StrawsonDesign/EduMiP/Pictures/Wide Pic Back.JPG

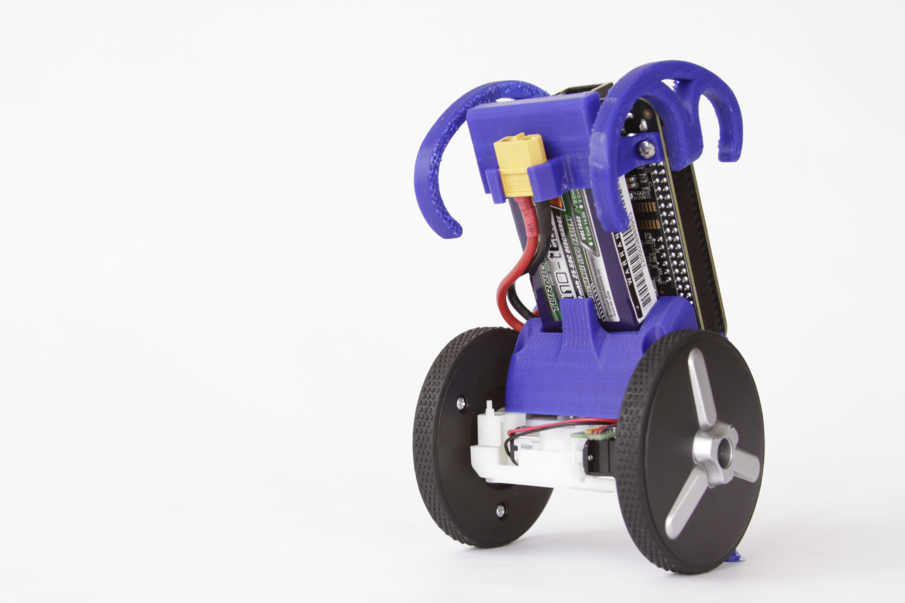
Pictures/Wide Pic Back.JPG
