StrawsonDesign/EduMiP/Renders/BeagleMiP Wide Back Render 1.JPG

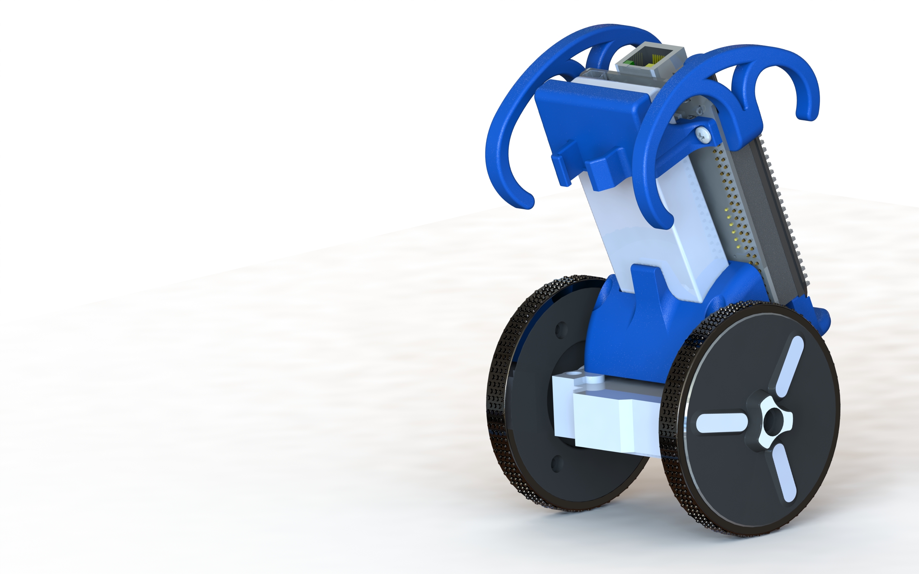
Renders/BeagleMiP Wide Back Render 1.JPG
