StrawsonDesign/EduMiP/README.md

# EduMiP
James Strawson 2015

EduMiP is a self-balancing robot built around the
BeagleBone Black and Robotics Cape.

Developed with the Coordinated Robotics Laboratory
at UCSD.
