StrawsonDesign/EduMiP/Pictures/EduMiP army 2.JPG

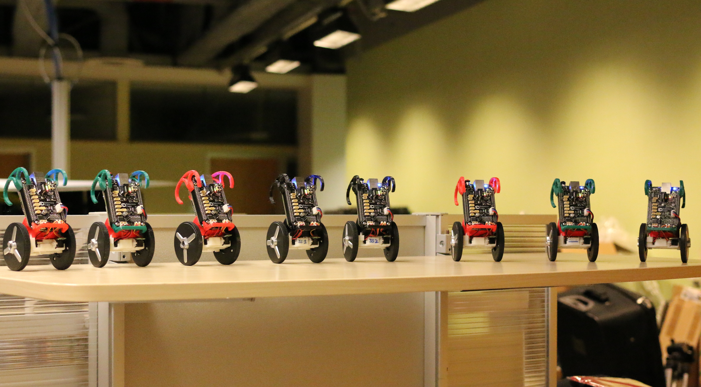
Pictures/EduMiP army 2.JPG
