StrawsonDesign/EduMiP/Pictures/Wide Pic Front.JPG

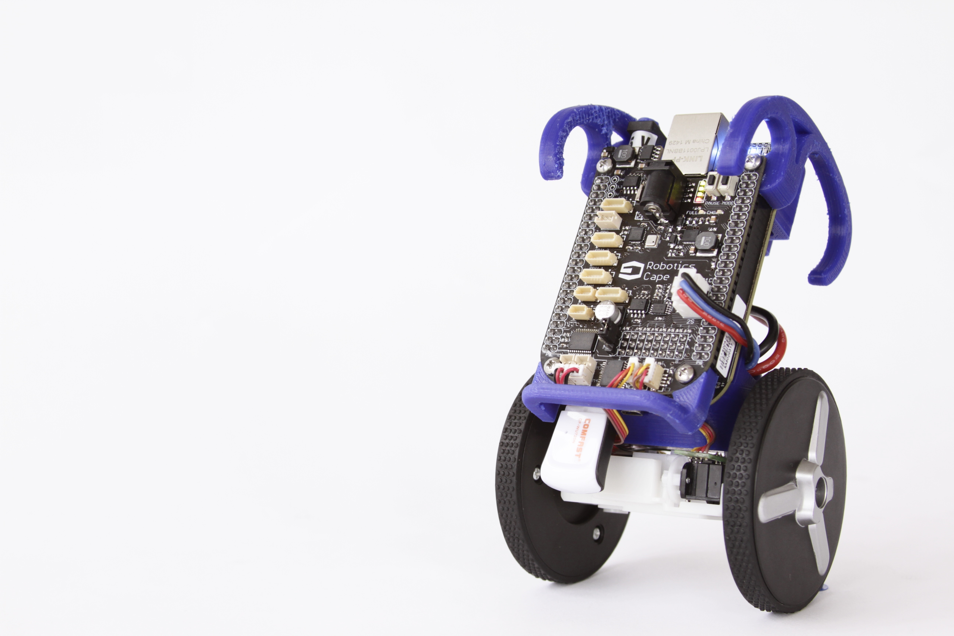
Pictures/Wide Pic Front.JPG
