StrawsonDesign/EduMiP/Renders/BeagleMiP Tall Back Render.png

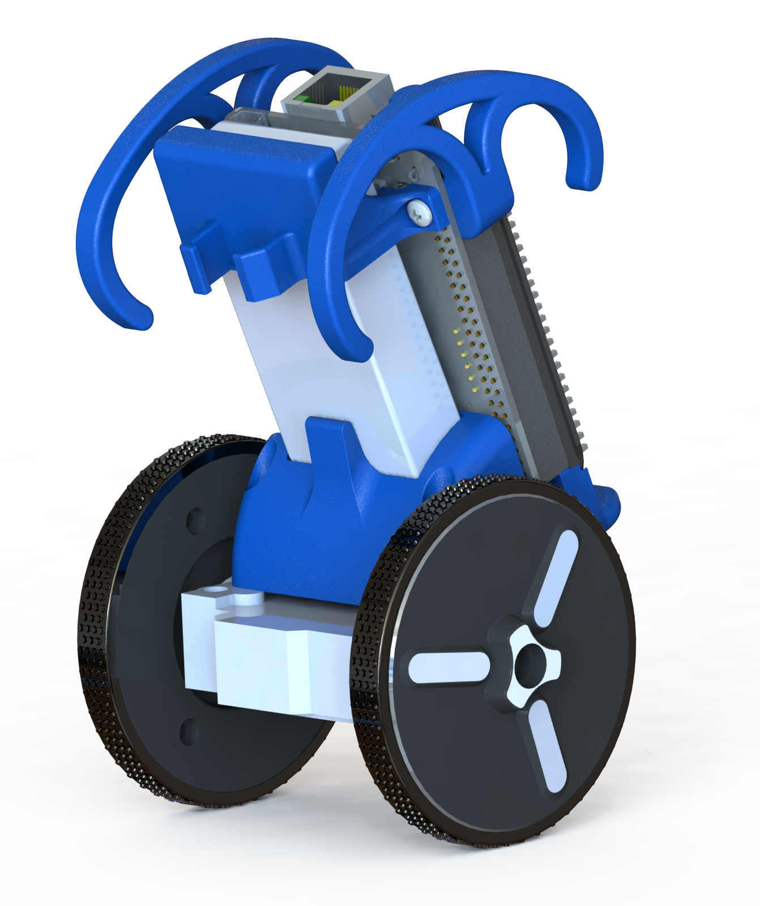
Renders/BeagleMiP Tall Back Render.png
