StrawsonDesign/EduMiP/Renders/BeagleMiP Tall Front Render.png

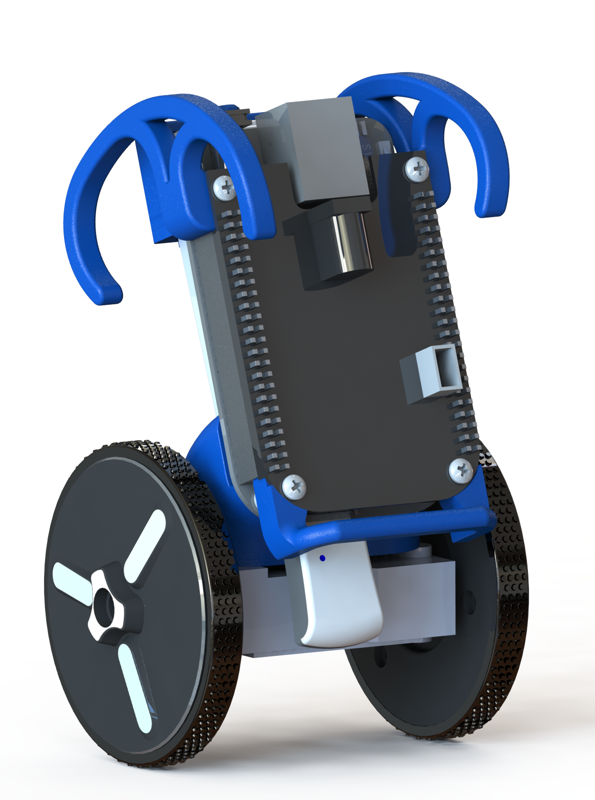
Renders/BeagleMiP Tall Front Render.png
