StrawsonDesign/EduMiP/Renders/BeagleMiP Wide Back Render 2.JPG

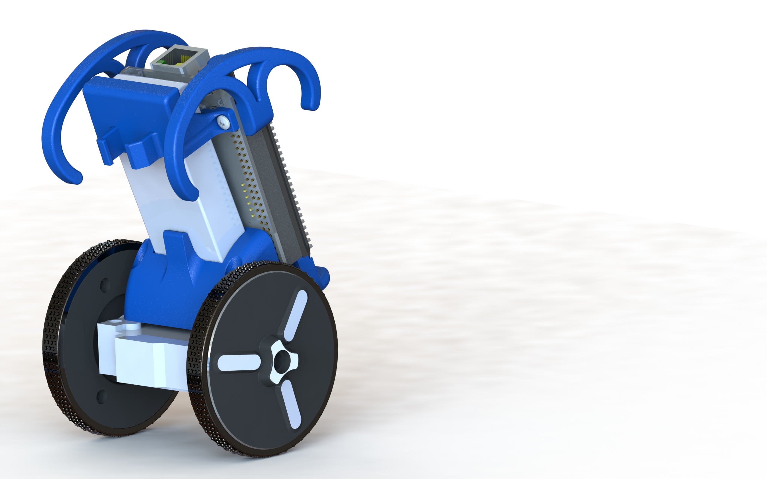
Renders/BeagleMiP Wide Back Render 2.JPG
