StrawsonDesign/EduMiP/Renders/BeagleMiP Wide Back Render 2.png

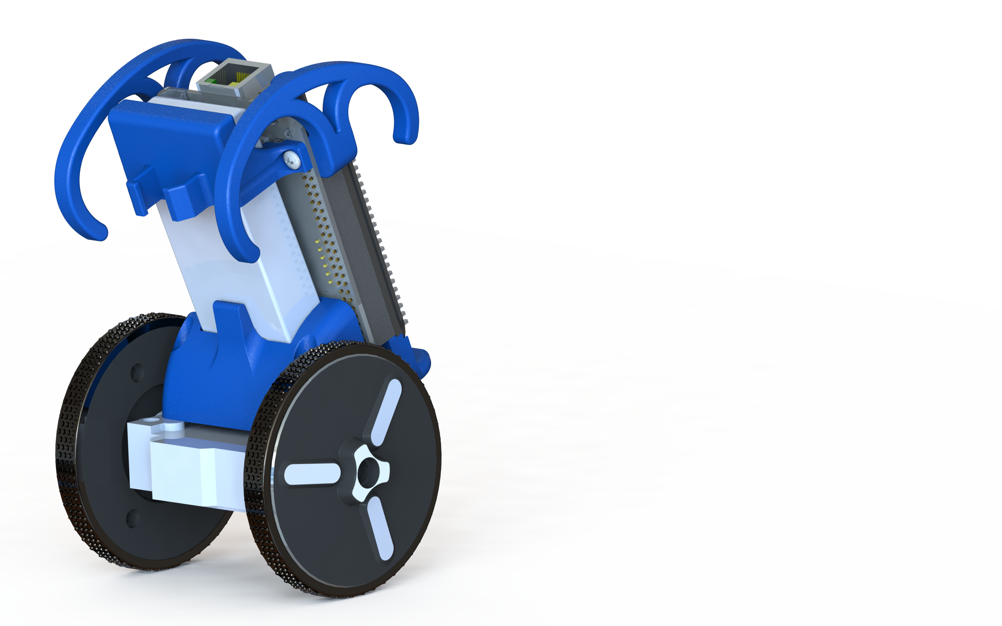
Renders/BeagleMiP Wide Back Render 2.png
