StrawsonDesign/EduMiP/Renders/BeagleMiP Wide Front Render.JPG

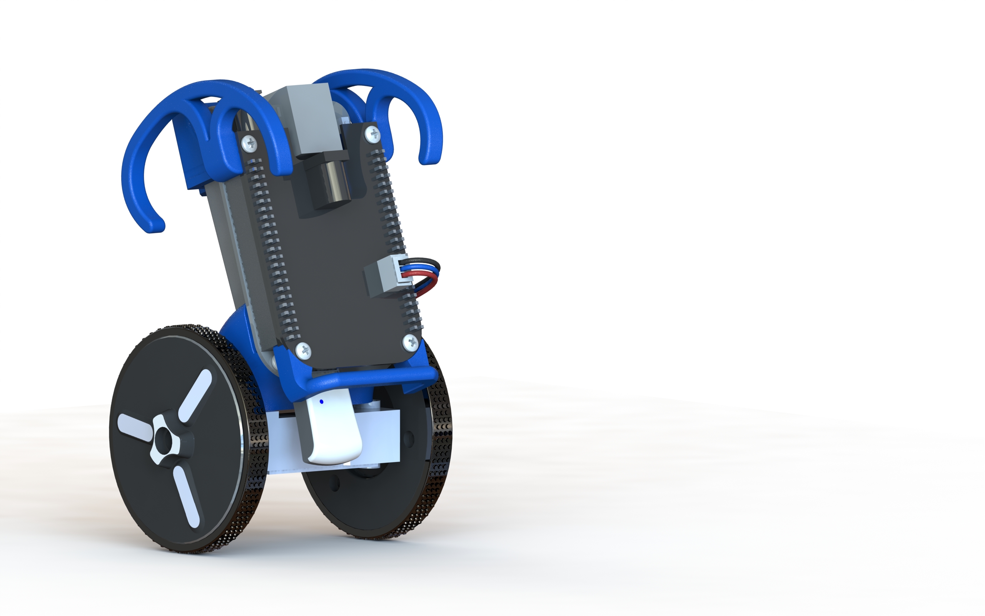
Renders/BeagleMiP Wide Front Render.JPG
