StrawsonDesign/EduMiP/Renders/BeagleMiP Wide Front Render.png

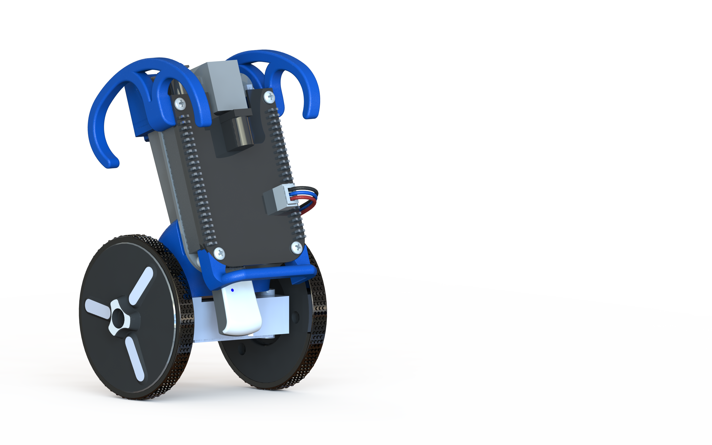
Renders/BeagleMiP Wide Front Render.png
