StrawsonDesign/EduMiP/solidworks/Accessories/eduMiP Accessories.sldasm

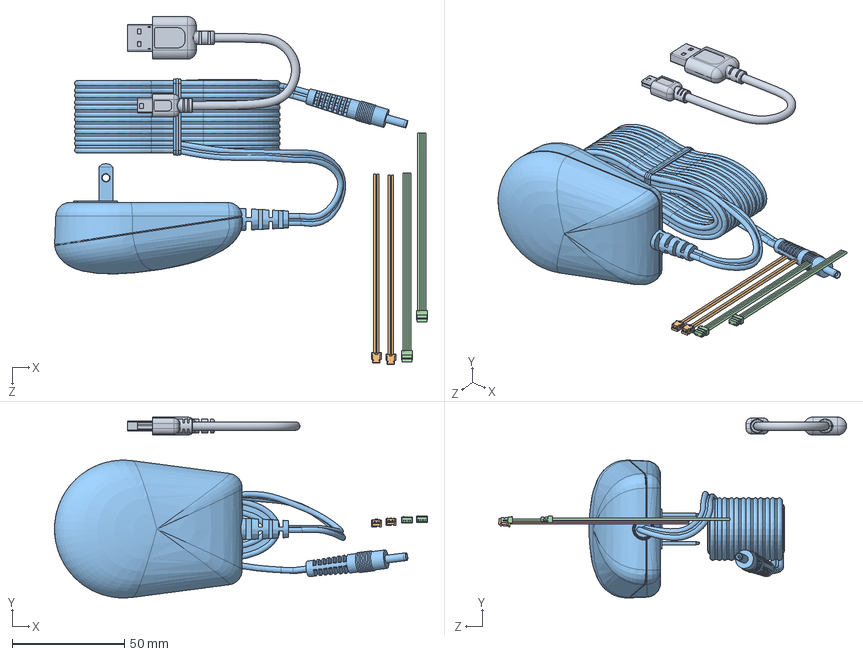
[picture p11: CAD file, 2015-08-29]
solidworks/Accessories/eduMiP Accessories.sldasm
165.9 x 80.4 x 154.8 mm
JST SH 4-Pin Pigtail x 2
12v 1A DC power supply
JST ZH 2-Pin Pigtail x 2
mini usb cable
