StrawsonDesign/EduMiP/solidworks/Accessories/Servo Accessory Bracket.SLDPRT

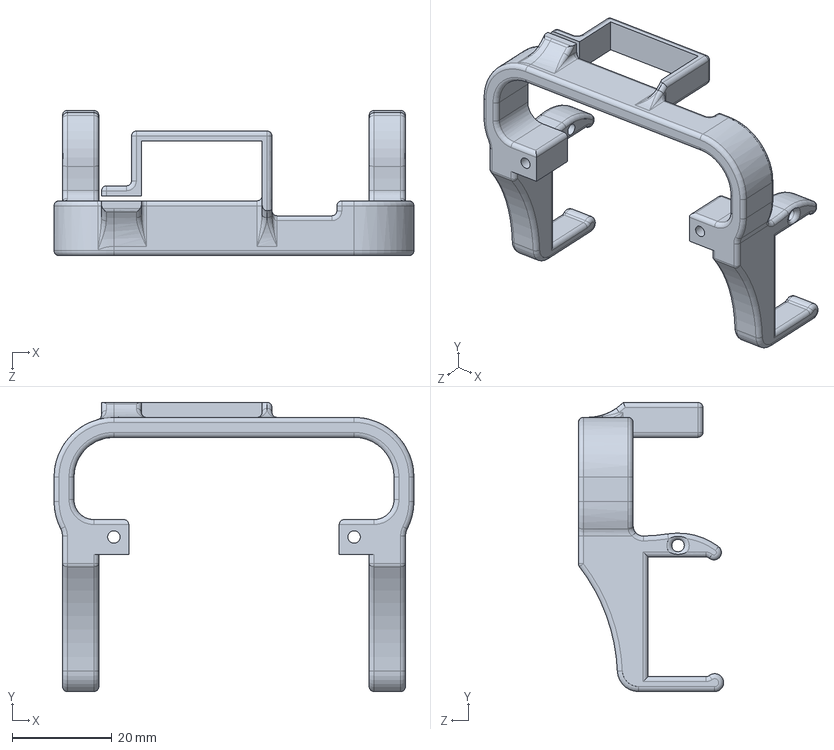
[picture p12: CAD file, 2015-08-29]
solidworks/Accessories/Servo Accessory Bracket.SLDPRT
72.2 x 58.0 x 29.1 mm
