StrawsonDesign/EduMiP/solidworks/Commercial MiP parts/WW inner wheel half.SLDPRT

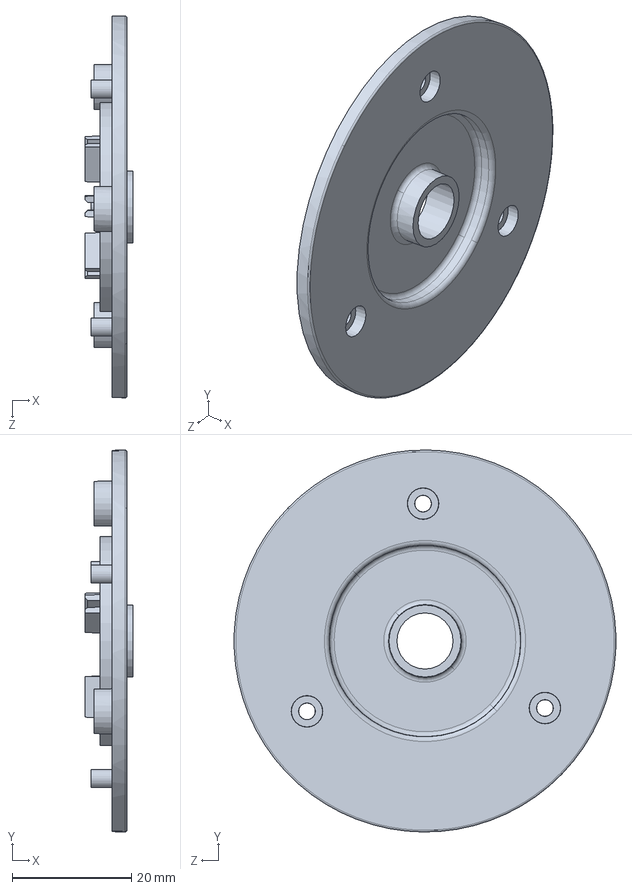
[picture p13: CAD file, 2015-08-29]
solidworks/Commercial MiP parts/WW inner wheel half.SLDPRT
7.97 x 63.9 x 63.9 mm
