StrawsonDesign/EduMiP/solidworks/ElectroMechanical/BeagleBone Black Rough.SLDPRT

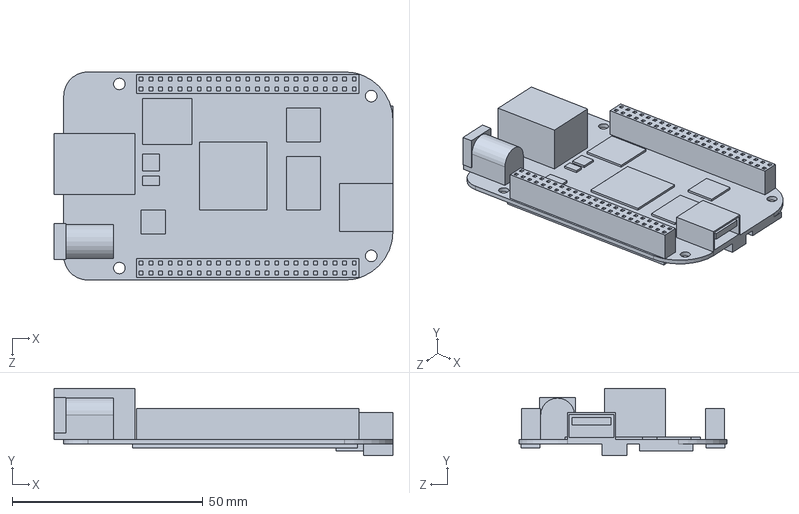
[picture p14: CAD file, 2015-08-29]
solidworks/ElectroMechanical/BeagleBone Black Rough.SLDPRT
88.9 x 17.6 x 54.6 mm
