StrawsonDesign/EduMiP/solidworks/Plastic Parts/SD-108 Bulkhead.sldprt

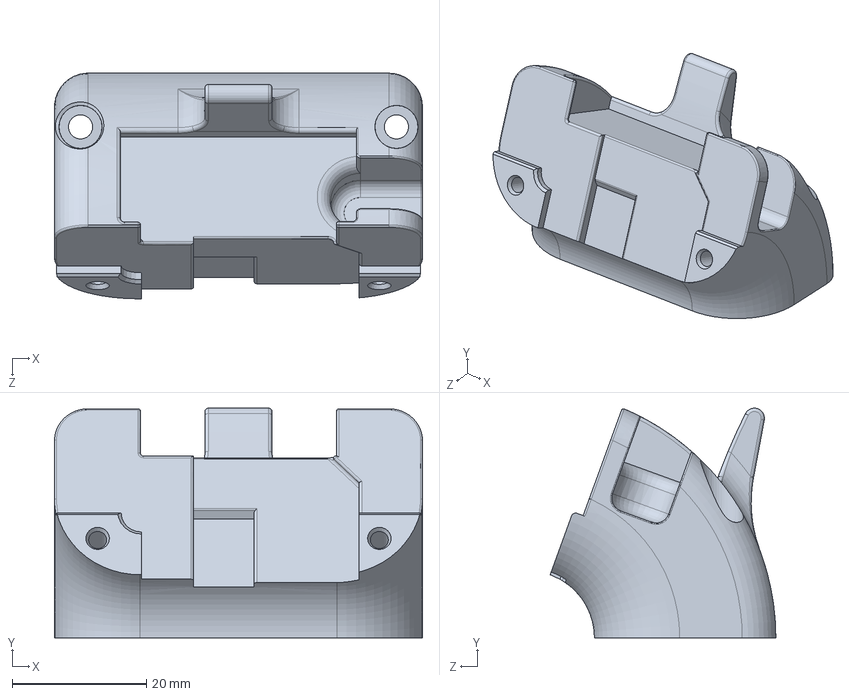
[picture p15: CAD file, 2015-08-29]
solidworks/Plastic Parts/SD-108 Bulkhead.sldprt
54.8 x 34.2 x 33.6 mm
