StrawsonDesign/EduMiP/STL/SD-105 DC Plug.STL

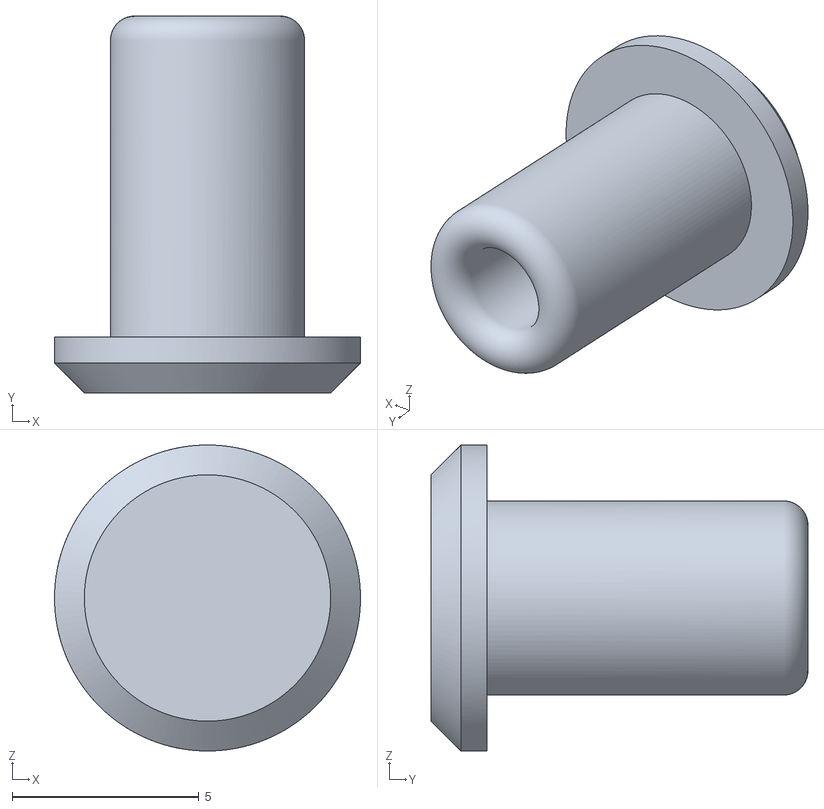
[picture p16: CAD file, 2015-08-29]
STL/SD-105 DC Plug.STL
8.20 x 10.1 x 8.20
