StrawsonDesign/EduMiP/solidworks/Accessories/JST SH 4-Pin Pigtail.SLDPRT

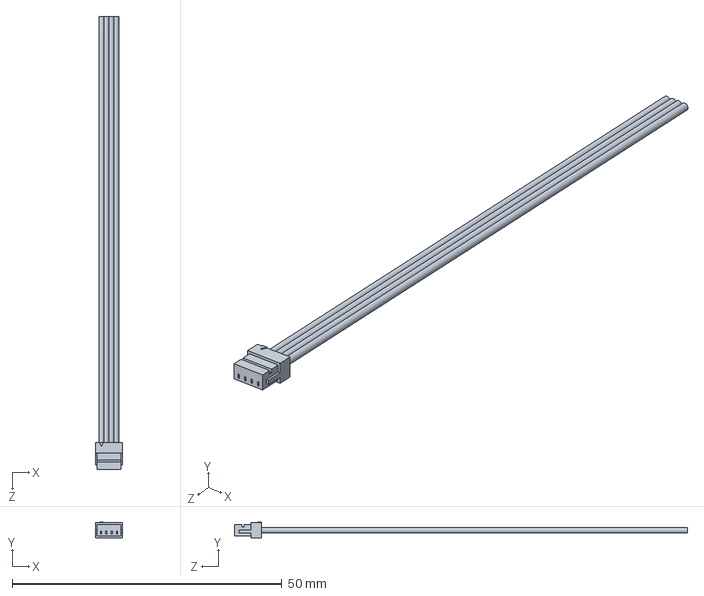
[picture p17: CAD file, 2015-08-29]
solidworks/Accessories/JST SH 4-Pin Pigtail.SLDPRT
5.00 x 2.90 x 84.0 mm
