StrawsonDesign/EduMiP/solidworks/Commercial MiP parts/WW drivetrain.SLDPRT

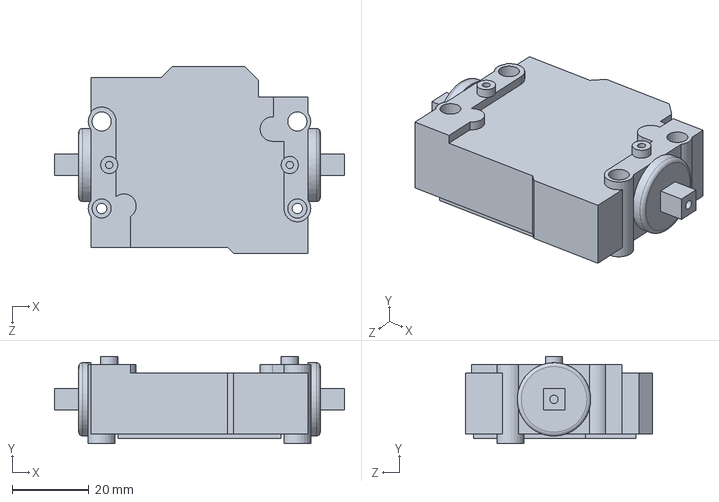
[picture p18: CAD file, 2015-08-29]
solidworks/Commercial MiP parts/WW drivetrain.SLDPRT
75.5 x 22.8 x 48.6 mm
