StrawsonDesign/EduMiP/solidworks/ElectroMechanical/Turnigy Nanotech 1300mah 2S N1300.2S.25.SLDPRT

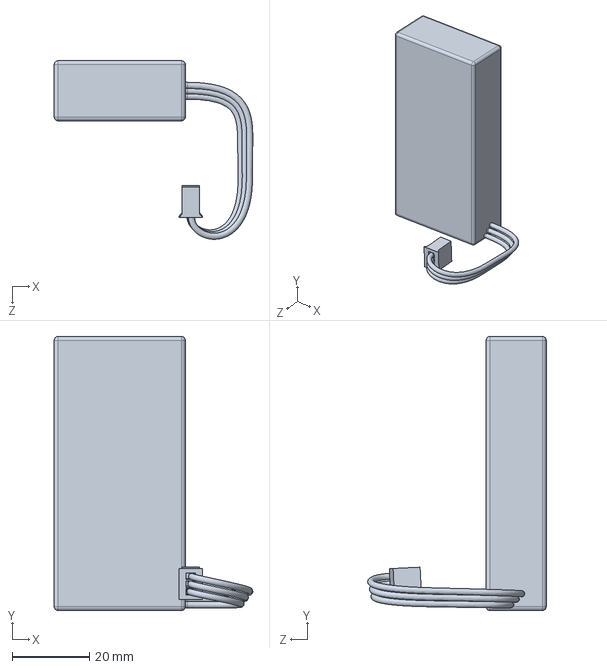
[picture p19: CAD file, 2015-08-29]
solidworks/ElectroMechanical/Turnigy Nanotech 1300mah 2S N1300.2S.25.SLDPRT
51.5 x 71.0 x 46.3 mm
