StrawsonDesign/EduMiP/STL/SD-107 Top Battery Clip.STL

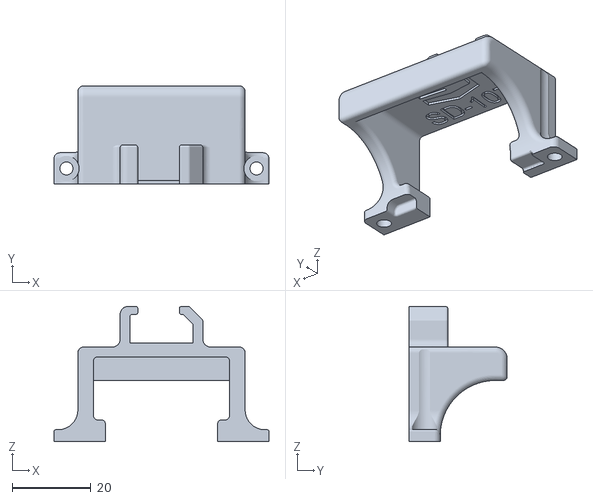
[picture p20: CAD file, 2015-08-29]
STL/SD-107 Top Battery Clip.STL
54.6 x 25.0 x 34.3
