StrawsonDesign/EduMiP/solidworks/Accessories/wifi dongle.SLDPRT

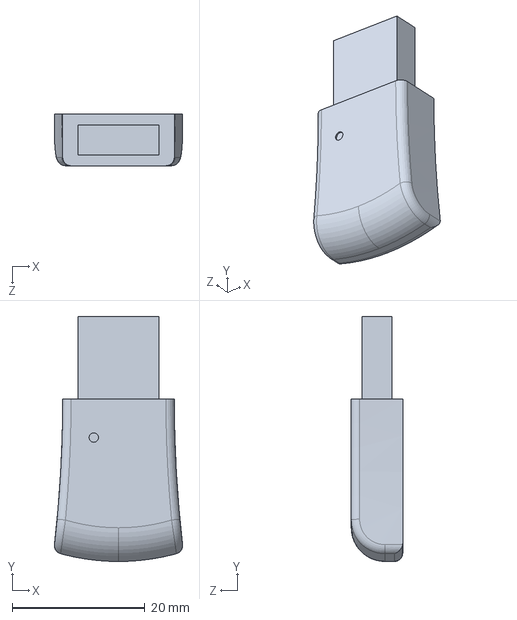
[picture p21: CAD file, 2015-08-29]
solidworks/Accessories/wifi dongle.SLDPRT
19.3 x 36.9 x 7.77 mm
