StrawsonDesign/EduMiP/solidworks/Commercial MiP parts/WW outer wheel half.SLDPRT

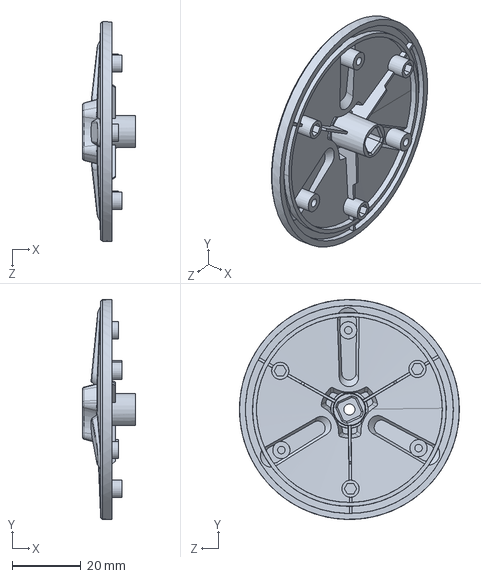
[picture p22: CAD file, 2015-08-29]
solidworks/Commercial MiP parts/WW outer wheel half.SLDPRT
15.3 x 63.9 x 63.9 mm
