StrawsonDesign/EduMiP/solidworks/ElectroMechanical/1400mah battery.SLDPRT

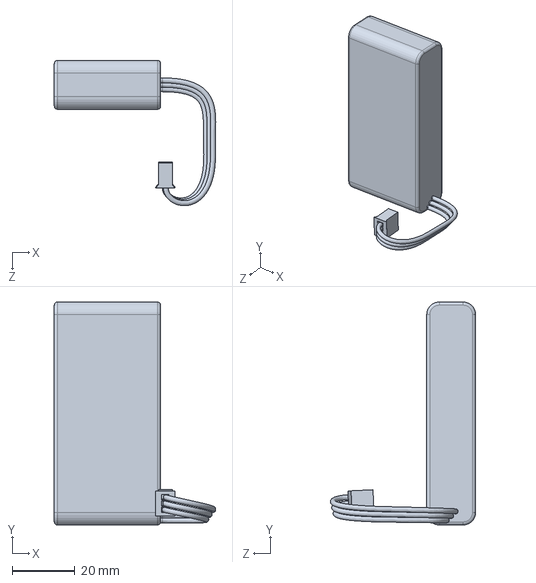
[picture p23: CAD file, 2015-08-29]
solidworks/ElectroMechanical/1400mah battery.SLDPRT
51.4 x 71.0 x 46.3 mm
