StrawsonDesign/EduMiP/solidworks/Plastic Parts/top skid.SLDPRT

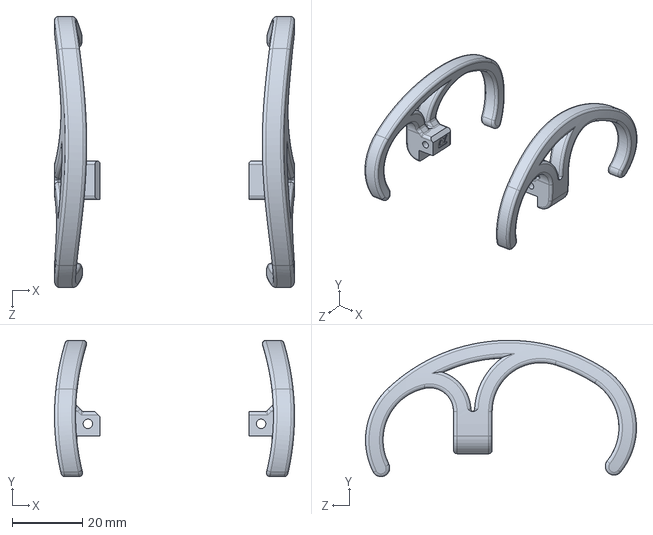
[picture p24: CAD file, 2015-08-29]
solidworks/Plastic Parts/top skid.SLDPRT
68.2 x 38.7 x 77.0 mm
