StrawsonDesign/EduMiP/STL/SD-110 Top Skid Right.STL

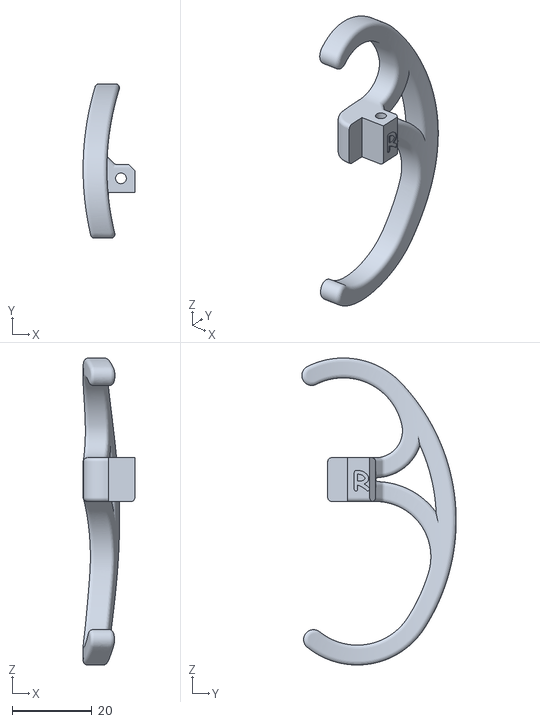
[picture p25: CAD file, 2015-08-29]
STL/SD-110 Top Skid Right.STL
13.0 x 38.7 x 77.0
