StrawsonDesign/EduMiP/solidworks/Accessories/JST ZH 2-Pin Pigtail.SLDPRT

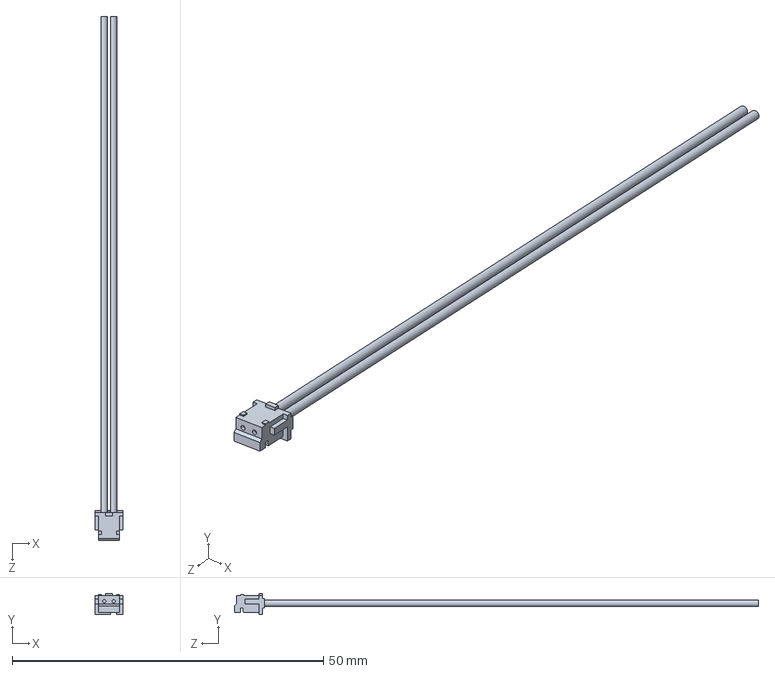
[picture p26: CAD file, 2015-08-29]
solidworks/Accessories/JST ZH 2-Pin Pigtail.SLDPRT
4.50 x 3.40 x 84.2 mm
