StrawsonDesign/EduMiP/solidworks/ElectroMechanical/SD-101C Robotics Cape.SLDPRT

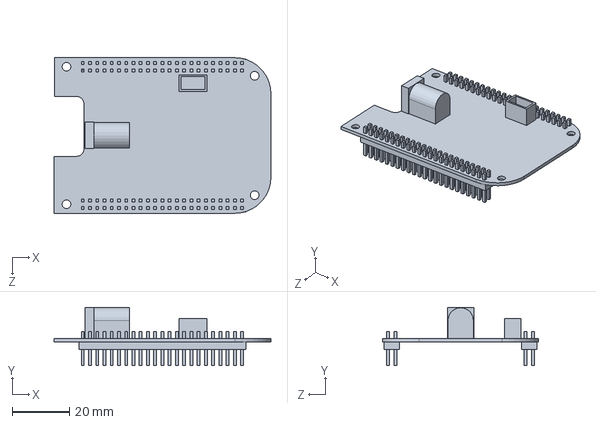
[picture p27: CAD file, 2015-08-29]
solidworks/ElectroMechanical/SD-101C Robotics Cape.SLDPRT
76.1 x 20.5 x 54.6 mm
