StrawsonDesign/EduMiP/solidworks/Accessories/mini usb cable.SLDPRT

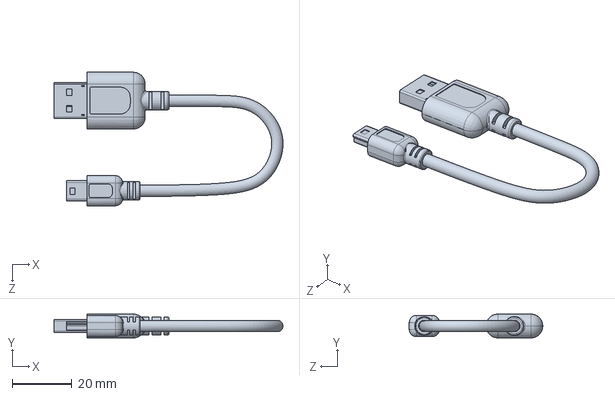
[picture p28: CAD file, 2015-08-29]
solidworks/Accessories/mini usb cable.SLDPRT
76.6 x 8.00 x 44.7 mm
