StrawsonDesign/EduMiP/solidworks/ElectroMechanical/encoder board.SLDPRT

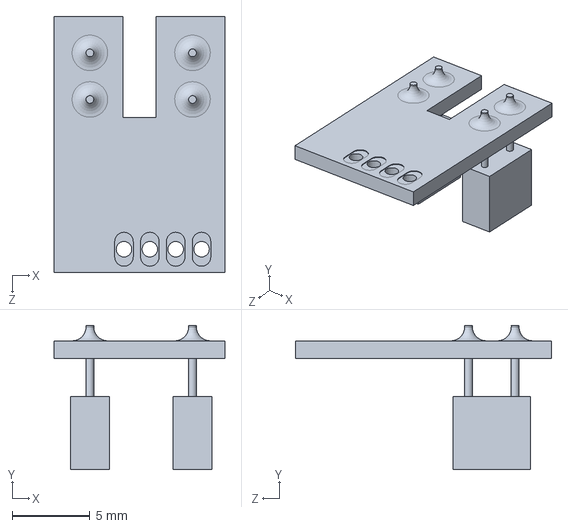
[picture p29: CAD file, 2015-08-29]
solidworks/ElectroMechanical/encoder board.SLDPRT
11.0 x 9.30 x 16.5 mm
