StrawsonDesign/EduMiP/STL/SD-111 Lower Front Bumper.STL

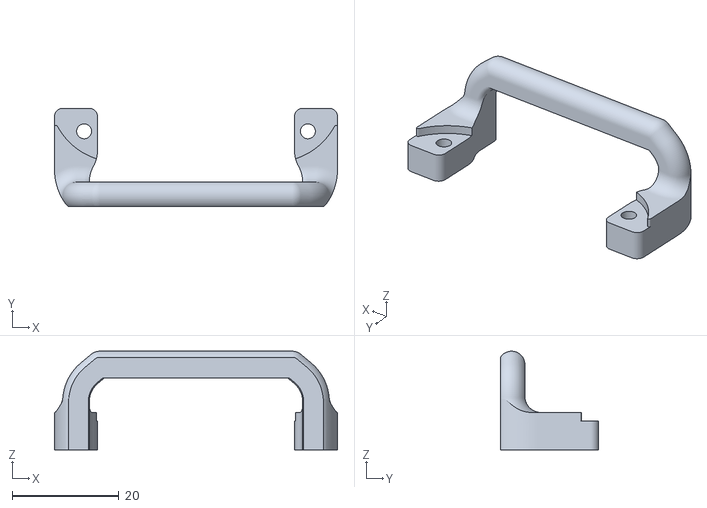
[picture p30: CAD file, 2015-08-29]
STL/SD-111 Lower Front Bumper.STL
53.0 x 18.4 x 18.5
