StrawsonDesign/EduMiP/solidworks/Accessories/12v 1A DC power supply.SLDPRT

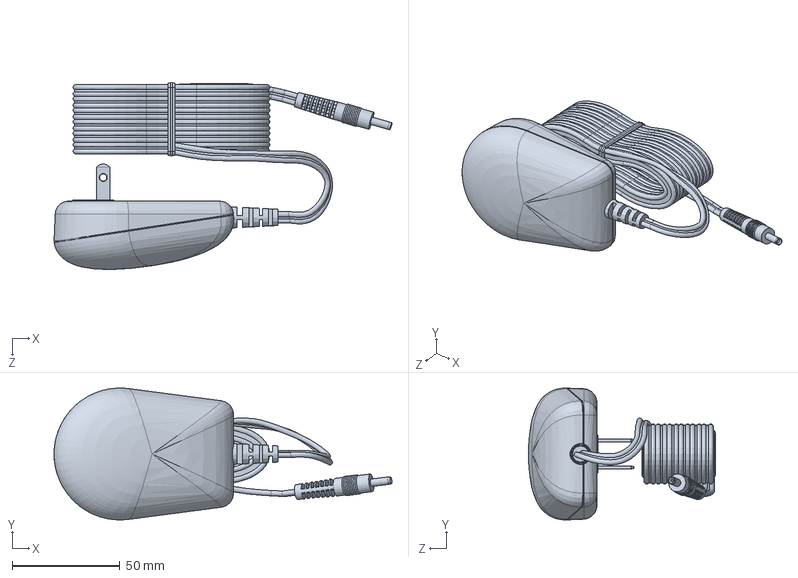
[picture p31: CAD file, 2015-08-29]
solidworks/Accessories/12v 1A DC power supply.SLDPRT
157.1 x 61.3 x 87.0 mm
