StrawsonDesign/EduMiP/(list of files, cad)

Other CAD files:
solidworks/Plastic Parts/SD-105 DC Plug.SLDPRT
solidworks/Plastic Parts/SD-110 Top Skid Right.SLDPRT
STL/SD-108 Bulkhead.STL
solidworks/Plastic Parts/SD-107 Top Battery Clip.SLDPRT
STL/SD-109 Top Skid Left.STL
solidworks/Plastic Parts/SD-109 Top Skid Left.SLDPRT
solidworks/Plastic Parts/SD-111 Lower Front Bumper.SLDPRT
solidworks/Accessories/Philips Screwdriver.SLDPRT
solidworks/SD-103 BeagleMIP.SLDDRW
solidworks/hardware/4-40 .375in BHCS McMaster 91772A108.SLDPRT
solidworks/hardware/4-40 0.25in BHCS McMaster 91772A106.SLDPRT
