StrawsonDesign/EduMiP/(threads)

Thread 1 (2017-03-31):

Where to buy the power train ?

Jeshwanth, 2017-03-31:
I am keep searching to buy the motor and wheel power train for EduMIP.. But not able to find it. Can you please post the link where to buy it ?

Tibalt, 2017-09-29:
have you got the power train? I am looking after it right now.

StrawsonDesign, 2017-10-19:
https://www.renaissancerobotics.com/

Dept. Mechanical & Aerospace Engineering
University of California, San Diego

On Thu, Sep 28, 2017 at 7:25 PM, Tibalt Zhao <notifications@github.com>
wrote:

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

Tibalt, 2017-10-25:
aha, thanks

LucianoMoretti, 2020-03-25:
Is there another source or some sort of part number? Renaissance Robotics is out of stock of the kits and doesn't list the motor/gearbox separately.
