StrawsonDesign/EduMiP/(commit log)

2015-08-29 first proper commit
    [12v 1A DC power supply.SLDPRT, 1400mah battery.SLDPRT, 4-40 .375in BHCS McMaster 91772A108.SLDPRT, 4-40 0.25in BHCS McMaster 91772A106.SLDPRT, BeagleBone Black Rough.SLDPRT, JST SH 4-Pin Pigtail.SLDPRT, JST ZH 2-Pin Pigtail.SLDPRT, Philips Screwdriver.SLDPRT]
2015-11-19 Add Assembly Instructions
2015-11-19 added complementary filter homework
2016-11-14 add pictures and renders
    [12v 1A DC power supply.SLDPRT, 1400mah battery.SLDPRT, 4-40 .375in BHCS McMaster 91772A108.SLDPRT, 4-40 0.25in BHCS McMaster 91772A106.SLDPRT, BeagleBone Black Rough.SLDPRT, JST SH 4-Pin Pigtail.SLDPRT, JST ZH 2-Pin Pigtail.SLDPRT, Philips Screwdriver.SLDPRT]
